sthiru/turbulence_chamber/web/1.jpg

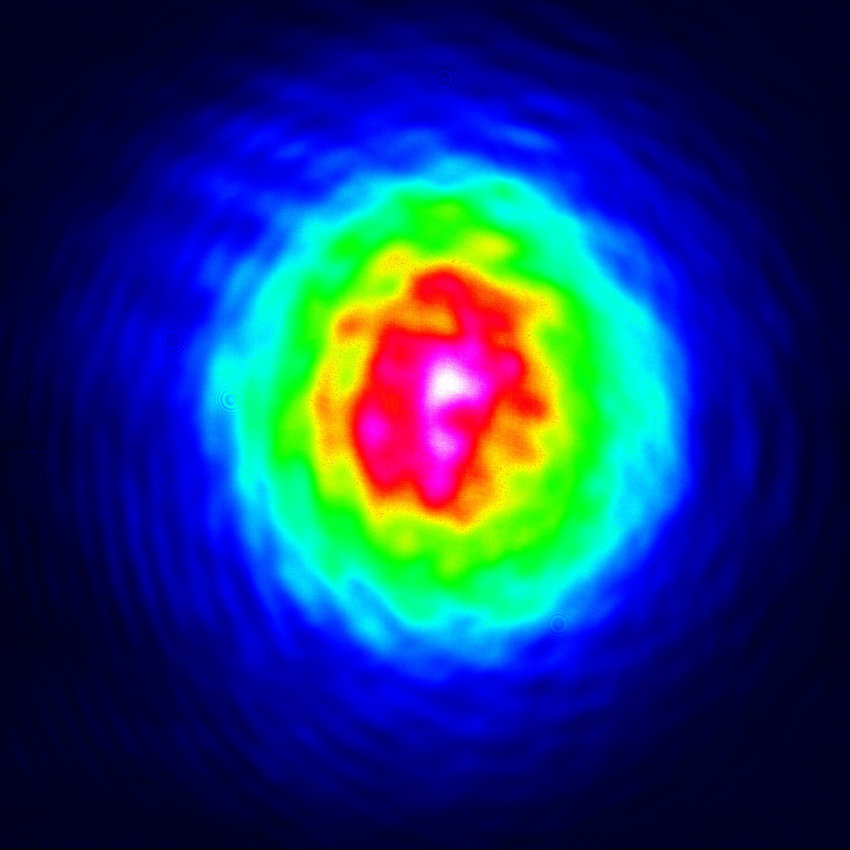
web/1.jpg
