sthiru/turbulence_chamber/calibration_data/windflow_calib_20260519_151501/calibration_data.csv

timestamp | fan_speed | sensor_0_avg | sensor_1_avg | sensor_2_avg | sensor_3_avg
2026-05-19T15:15:03.468255 | 15 | 0.117759 | -0.1286 | -0.011482 | -0.013691
2026-05-19T15:15:05.126720 | 20 | -0.05001933333333333 | -0.14201 | -0.16229866666666667 | -0.03581433333333334
2026-05-19T15:15:06.347077 | 25 | -0.108659 | -0.148715 | -0.189466 | -0.043848
2026-05-19T15:15:07.566888 | 30 | -0.08888800000000001 | -0.108659 | -0.1286 | -0.043848
2026-05-19T15:15:09.152624 | 35 | -0.11536266666666666 | -0.1286 | -0.189466 | -0.074759
2026-05-19T15:15:10.369626 | 40 | -0.108659 | -0.1286 | -0.189466 | -0.043848
2026-05-19T15:15:11.588987 | 45 | -0.069285 | -0.069285 | -0.148715 | -0.043848
2026-05-19T15:15:13.452653 | 50 | -0.10206866666666665 | -0.10882833333333332 | -0.16253033333333333 | -0.054151666666666674
2026-05-19T15:15:15.165092 | 55 | -0.037284 | -0.12195299999999999 | -0.16229866666666667 | -0.05440300000000001
2026-05-19T15:15:16.385413 | 60 | -0.069285 | -0.1286 | -0.169003 | -0.138907
2026-05-19T15:15:17.606574 | 65 | -0.011482 | -0.069285 | -0.169003 | -0.043848
2026-05-19T15:15:19.190825 | 70 | 0.0008739999999999998 | -0.049852 | -0.08240966666666666 | 0.005924333333333333
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
