sthiru/turbulence_chamber/calibration_data/windflow_calib_20260519_151501/windflow_data.csv

timestamp | step | fan_id | fan_speed | flow_rate_sensor_0 | flow_rate_sensor_1 | flow_rate_sensor_2 | flow_rate_sensor_3 | sensor_temp_0 | sensor_temp_1 | sensor_temp_2 | sensor_temp_3 | sensor_temp_4 | sensor_temp_5 | sensor_temp_6 | sensor_temp_7 | sensor_temp_8 | sensor_temp_9 | sensor_temp_10 | sensor_temp_11 | temp_hotplate1 | temp_hotplate2 | bmpTemperature_internal | bmpTemperature_external | bmpPressure_internal | bmpPressure_external | dhtTemperature_internal | dhtTemperature_external | dhtHumidity_internal | dhtHumidity_external | air_flow_0 | air_flow_1 | air_flow_2 | air_flow_3
2026-05-19T15:15:03.409338 | 1 | all | 15 | 0.117759 | -0.1286 | -0.011482 | -0.013691 | 28.0 | 25.375 | 27.1875 | 26.125 | 26.5 | 25.6875 | 24.75 | 25.75 | 25.25 | 26.0 | 25.25 | 27.25
2026-05-19T15:15:04.699962 | 2 | all | 20 | -0.05001933333333333 | -0.14201 | -0.16229866666666667 | -0.03581433333333334 | 28.0 | 25.375 | 27.1875 | 26.125 | 26.5 | 25.6875 | 24.75 | 25.75 | 25.25 | 26.0 | 25.25 | 27.25
2026-05-19T15:15:06.288640 | 3 | all | 25 | -0.108659 | -0.148715 | -0.189466 | -0.043848 | 27.9375 | 25.375 | 27.1875 | 26.125 | 26.5 | 25.6875 | 24.75 | 25.75 | 25.25 | 26.0 | 25.25 | 27.25
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
