sthiru/turbulence_chamber/calibration_data/calibration_data.csv

timestamp | fan_speed | sensor_0_avg | sensor_1_avg | sensor_2_avg | sensor_3_avg
2026-05-19T23:00:33.695771 | 15 | 0.1356 | -0.23092499999999996 | -0.011482 | -0.043848
2026-05-19T23:00:35.357202 | 20 | -0.043484999999999996 | -0.06945433333333334 | -0.09576166666666668 | 0.015012666666666669
2026-05-19T23:00:36.655126 | 25 | -0.069285 | -0.069285 | -0.148715 | 0.015732
2026-05-19T23:00:37.958576 | 30 | -0.069285 | -0.08888800000000001 | -0.169003 | 0.015732
2026-05-19T23:00:39.553179 | 35 | -0.069285 | -0.030585 | -0.148715 | -0.043848
2026-05-19T23:00:40.857397 | 40 | -0.069285 | -0.08888800000000001 | -0.148715 | -0.013691
2026-05-19T23:00:43.393942 | 45 | -0.08235366666666667 | -0.07581933333333334 | -0.122011 | -0.013691
2026-05-19T23:00:44.693126 | 50 | 0.007459 | 0.007459 | -0.1286 | -0.013691
2026-05-19T23:00:45.990155 | 55 | -0.049852 | -0.08888800000000001 | -0.108659 | 0.044443
2026-05-19T23:00:47.580486 | 60 | -0.030585 | -0.08888800000000001 | -0.069285 | -0.043848
2026-05-19T23:00:48.906778 | 65 | -0.011482 | -0.108659 | -0.049852 | 0.07246
2026-05-19T23:00:51.441155 | 70 | -0.005168333333333333 | -0.08888800000000001 | -0.09547833333333333 | -0.035025
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
