sthiru/turbulence_chamber/calibration_data/pid_data/turbulence_data_20260518_113139.csv

timestamp | session_id | temp_sensor_1 | temp_sensor_2 | temp_sensor_3 | temp_sensor_4 | temp_sensor_5 | temp_sensor_6 | temp_sensor_7 | temp_sensor_8 | temp_sensor_9 | temp_sensor_10 | temp_sensor_11 | temp_sensor_12 | temp_hotplate1 | temp_hotplate2 | bmpTemperature_internal | bmpTemperature_external | bmpPressure_internal | bmpPressure_external | dhtTemperature_internal | dhtTemperature_external | dhtHumidity_internal | dhtHumidity_external | target_temp_1 | target_temp_2 | fan_speed_1 | fan_speed_2 | fan_speed_3 | fan_speed_4 | hot_plate_1 | hot_plate_2 | flow_rate_1 | flow_rate_2 | flow_rate_3 | flow_rate_4 | cn2_row1_500 | cn2_row1_300 | cn2_row2_500 | cn2_row2_300 | cn2_optical | image_filename
2026-05-18T11:31:23.663784 | session_2026-05-18T06-01-23-053Z | 23.375 | 23.0 | 23.6875 | 23.4375 | 23.5 | 23.375 | 22.75 | 23.5 | 23.25 | 23.25 | 23.5 | 24.0 | 24.75 | 24.5 | 27.12 | 26.32 | 945.5203 | 946.0911 | -273.0 | 25.9 | 0.0 | 35.9 | 100.0 | 100.0 | 255 | 255 | 255 | 255 | True | True | 0.401474 | -0.049852 | 0.322193 | 0.044443 | 1.5485734400537575e-13 | 9.674943881185475e-14 | 4.3015928890382153e-13 | 9.674943881185475e-14 |  | camera_20260518_113123_938.png
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
