sthiru/turbulence_chamber/calibration_data/pid_data/turbulence_data_20260518_181109.csv

timestamp | session_id | temp_sensor_1 | temp_sensor_2 | temp_sensor_3 | temp_sensor_4 | temp_sensor_5 | temp_sensor_6 | temp_sensor_7 | temp_sensor_8 | temp_sensor_9 | temp_sensor_10 | temp_sensor_11 | temp_sensor_12 | temp_hotplate1 | temp_hotplate2 | bmpTemperature_internal | bmpTemperature_external | bmpPressure_internal | bmpPressure_external | dhtTemperature_internal | dhtTemperature_external | dhtHumidity_internal | dhtHumidity_external | target_temp_1 | target_temp_2 | fan_speed_1 | fan_speed_2 | fan_speed_3 | fan_speed_4 | hot_plate_1 | hot_plate_2 | flow_rate_1 | flow_rate_2 | flow_rate_3 | flow_rate_4 | cn2_row1_500 | cn2_row1_300 | cn2_row2_500 | cn2_row2_300 | cn2_optical | image_filename
2026-05-18T18:00:28.386229 | session_2026-05-18T12-30-27-949Z | 25.625 | 22.5625 | 25.0625 | 23.5625 | 24.5 | 23.3125 | 21.75 | 23.25 | 22.5 | 23.75 | 22.75 | 25.25 | 103.25 | 115.5 | 23.71 | -12.83 | 920.3487 | 942.6061 | -273.0 | -273.0 | 39.0 | 37.1 | 100.0 | 100.0 | 255 | 255 | 255 | 255 | False | False | 0.492373 | -0.011482 | 0.338316 | 0.296232 | 1.0134238366158497e-11 | 3.4175950724420715e-12 | 2.6380253972715787e-12 | 8.543987681105179e-13 |  | camera_20260518_180028_387.png
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
