sthiru/turbulence_chamber/calibration_data/pid_data/turbulence_data_20260518_223706.csv

timestamp | session_id | temp_sensor_1 | temp_sensor_2 | temp_sensor_3 | temp_sensor_4 | temp_sensor_5 | temp_sensor_6 | temp_sensor_7 | temp_sensor_8 | temp_sensor_9 | temp_sensor_10 | temp_sensor_11 | temp_sensor_12 | temp_hotplate1 | temp_hotplate2 | bmpTemperature_internal | bmpTemperature_external | bmpPressure_internal | bmpPressure_external | dhtTemperature_internal | dhtTemperature_external | dhtHumidity_internal | dhtHumidity_external | target_temp_1 | target_temp_2 | fan_speed_1 | fan_speed_2 | fan_speed_3 | fan_speed_4 | hot_plate_1 | hot_plate_2 | flow_rate_1 | flow_rate_2 | flow_rate_3 | flow_rate_4 | cn2_row1_500 | cn2_row1_300 | cn2_row2_500 | cn2_row2_300 | cn2_optical | image_filename
2026-05-18T22:14:59.239831 | session_2026-05-18T16-44-58-294Z | 24.8125 | 21.8125 | 23.8125 | 22.625 | 23.25 | 22.6875 | 21.0 | 22.25 | 21.75 | 22.75 | 22.0 | 24.0 | 122.0 | 118.0 | 24.98 | 24.81 | 945.2132 | 945.7065 | 22.9 | -273.0 | 39.0 | 0.0 | 100.0 | 100.0 | 255 | 255 | 255 | 255 | False | False | 0.536168 | -0.108659 | 0.256337 | -0.013691 | 1.0106738973377834e-11 | 2.2260501433209438e-12 | 3.19783537829533e-12 | 3.9464600878820054e-13
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
