sthiru/turbulence_chamber/calibration_data/pid_data/turbulence_data_20260518_230422.csv

timestamp | session_id | temp_sensor_1 | temp_sensor_2 | temp_sensor_3 | temp_sensor_4 | temp_sensor_5 | temp_sensor_6 | temp_sensor_7 | temp_sensor_8 | temp_sensor_9 | temp_sensor_10 | temp_sensor_11 | temp_sensor_12 | temp_hotplate1 | temp_hotplate2 | bmpTemperature_internal | bmpTemperature_external | bmpPressure_internal | bmpPressure_external | dhtTemperature_internal | dhtTemperature_external | dhtHumidity_internal | dhtHumidity_external | target_temp_1 | target_temp_2 | fan_speed_1 | fan_speed_2 | fan_speed_3 | fan_speed_4 | hot_plate_1 | hot_plate_2 | flow_rate_1 | flow_rate_2 | flow_rate_3 | flow_rate_4 | cn2_row1_500 | cn2_row1_300 | cn2_row2_500 | cn2_row2_300 | cn2_optical | image_filename
2026-05-18T22:53:31.025306 | session_2026-05-18T17-23-30-418Z | 24.6875 | 21.75 | 24.0625 | 22.75 | 23.5 | 22.75 | 0.0 | 22.75 | 22.0 | 23.0 | 22.0 | 24.5 | 100.5 | 111.0 | 25.13 | 24.82 | 945.1256 | 945.5635 | 23.1 | 23.4 | 38.7 | 36.7 | 100.0 | 100.0 | 255 | 255 | 255 | 255 | False | False | 0.354302 | -0.030585 | 0.305936 | 0.250612 | 9.686914948961821e-12 | 2.71848866593769e-12 | 5.810219479753941e-10 | 8.876697684694497e-13
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
