sthiru/turbulence_chamber/calibration_data/pid_data/turbulence_data_20260518_233700.csv

timestamp | session_id | temp_sensor_1 | temp_sensor_2 | temp_sensor_3 | temp_sensor_4 | temp_sensor_5 | temp_sensor_6 | temp_sensor_7 | temp_sensor_8 | temp_sensor_9 | temp_sensor_10 | temp_sensor_11 | temp_sensor_12 | temp_hotplate1 | temp_hotplate2 | bmpTemperature_internal | bmpTemperature_external | bmpPressure_internal | bmpPressure_external | dhtTemperature_internal | dhtTemperature_external | dhtHumidity_internal | dhtHumidity_external | target_temp_1 | target_temp_2 | fan_speed_1 | fan_speed_2 | fan_speed_3 | fan_speed_4 | hot_plate_1 | hot_plate_2 | flow_rate_1 | flow_rate_2 | flow_rate_3 | flow_rate_4 | cn2_row1_500 | cn2_row1_300 | cn2_row2_500 | cn2_row2_300 | cn2_optical | image_filename
2026-05-18T23:05:25.241983 | session_2026-05-18T17-35-24-660Z | 24.625 | 22.0 | 24.0625 | 22.875 | 23.5 | 22.375 | 21.25 | 22.5 | 22.0 | 22.75 | 22.0 | 24.5 | 101.25 | 89.75 | 24.99 | 24.75 | 944.785 | 945.3376 | -273.0 | -273.0 | 38.6 | 0.0 | 100.0 | 100.0 | 255 | 255 | 255 | 255 | False | True | 0.578911 | -0.273107 | 0.239522 | 0.494911 | 7.737192960962481e-12 | 2.2258260227207912e-12 | 1.4211170744624964e-12 | 3.9460627549620673e-13
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
