sthiru/turbulence_chamber/server/camera_acquisition.py

# -*- coding: utf-8 -*-
"""
Camera acquisition module for GigE Basler camera using Pylon SDK
Created for turbulence controller system
"""

import os
import time
import logging
import re
from datetime import datetime
from typing import Optional, Tuple, Dict, Any, Iterator, Generator
import cv2
import numpy as np
import threading
import queue
import base64
from io import BytesIO
from PIL import Image
from constants import (
    CAMERA_IMAGES_FOLDER,
    CAMERA_FRAME_QUEUE_SIZE,
    CAMERA_RETRIEVE_TIMEOUT,
    CAMERA_FILENAME_FORMAT,
    CAMERA_VIDEO_FRAME_DELAY,
    CAMERA_JPEG_QUALITY,
    CAMERA_IMAGE_EXTENSION
)

# Try to import pylon, provide fallback if not available
try:
    from pypylon import pylon
    PYLON_AVAILABLE = True
    # Debug: Print Pylon version info
    try:
        print(f"Pylon version: {pylon.PYLON_VERSIONSTRING_BUILD}")
        print(f"Pylon git sha: {pylon.PYLON_VERSIONSTRING_GITHASH}")
    except:
        print("Could not get Pylon version info")
except ImportError:
    PYLON_AVAILABLE = False

logger = logging.getLogger(__name__)

class BaslerCamera:
    """GigE Basler camera acquisition using Pylon SDK (Singleton)"""
    
    _instance = None
    _lock = threading.Lock()
    
    def __new__(cls, camera_images_folder: str = CAMERA_IMAGES_FOLDER):
        if cls._instance is None:
            with cls._lock:
                if cls._instance is None:
                    cls._instance = super().__new__(cls)
                    cls._instance._initialized = False
        return cls._instance
    
    def __init__(self, camera_images_folder: str = CAMERA_IMAGES_FOLDER):
        """
        Initialize camera acquisition (singleton)
        
        Args:
            camera_images_folder: Directory to save captured images
        """
        # Only initialize once
        if self._initialized:
            return
            
        self.camera_images_folder = camera_images_folder
        self.camera = None
        self.is_initialized = False
        self.is_connected = False
        
        # Camera settings
        self.camera_settings = {}  # Store loaded pfs settings
        
        # Video streaming variables
        self.is_streaming = False
        self.streaming_thread = None
        self.frame_queue = queue.Queue(maxsize=CAMERA_FRAME_QUEUE_SIZE)  # Buffer for video frames
        self.streaming_clients = []  # List of connected streaming clients
        
        # Ensure camera images folder exists
        os.makedirs(self.camera_images_folder, exist_ok=True)
        
        # Camera info
        self.camera_info = {}
        
        self._initialized = True
    
    @classmethod
    def get_instance(cls, camera_images_folder: str = CAMERA_IMAGES_FOLDER) -> 'BaslerCamera':
        """Get or create the singleton camera instance"""
        return cls(camera_images_folder)
    
    @classmethod
    def reset_instance(cls):
        """Reset the singleton instance (for testing)"""
        with cls._lock:
            if cls._instance:
                cls._instance.cleanup()
            cls._instance = None
        
    def load_pfs_settings(self, pfs_file_path: str) -> bool:
        """
        Load camera settings from a PFS (Pylon Feature Set) file
        
        Args:
            pfs_file_path: Path to the .pfs file
            
        Returns:
            bool: True if settings loaded successfully, False otherwise
        """
        try:
            if not os.path.exists(pfs_file_path):
                logger.error(f"PFS file not found: {pfs_file_path}")
                return False
                
            if not PYLON_AVAILABLE:
                logger.warning("Pylon SDK not available - cannot load PFS file")
                return False
                
            logger.info(f"Loading camera settings from PFS file: {pfs_file_path}")
            
            # Load and parse PFS file
            self.camera_settings = self._parse_pfs_file(pfs_file_path)
            
            # Log all loaded settings
            logger.info(f"Successfully loaded {len(self.camera_settings)} camera settings from PFS file")
                
            return True
            
        except Exception as e:
            logger.error(f"Failed to load PFS file {pfs_file_path}: {e}")
            return False
    
    def _parse_pfs_file(self, pfs_file_path: str) -> Dict[str, Any]:
        """
        Parse PFS file and extract camera settings
        
        Args:
            pfs_file_path: Path to the PFS file
            
        Returns:
            Dict containing camera parameter names and values
        """
        settings = {}
        
        try:
            with open(pfs_file_path, 'r') as f:
                lines = f.readlines()
                
            # Parse each line for parameter=value pairs
            for line in lines:
                line = line.strip()
                
                # Skip comments and empty lines
                if line.startswith('#') or not line or '\t' not in line:
                    continue
                    
                # Split parameter and value
                parts = line.split('\t')
                if len(parts) >= 2:
                    param_name = parts[0].strip()
                    param_value = parts[1].strip()
                    
                    # Convert value to appropriate type
                    if param_value.replace('.', '').isdigit():
                        # Numeric value
                        if '.' in param_value:
                            settings[param_name] = float(param_value)
                        else:
                            settings[param_name] = int(param_value)
                    else:
                        # String value
                        settings[param_name] = param_value
                        
        except Exception as e:
            logger.warning(f"Error parsing PFS file: {e}")
            
        return settings
    
    def apply_pfs_settings_to_camera(self) -> bool:
        """
        Apply loaded PFS settings to the camera
        
        Returns:
            bool: True if settings applied successfully, False otherwise
        """
        try:
            if not self.camera or not self.camera.IsOpen():
                logger.error("Camera not available for applying settings")
                return False
                
            if not self.camera_settings:
                logger.warning("No PFS settings loaded to apply")
                return False
                
            logger.info("Applying PFS settings to camera...")
            
            # Apply all settings from PFS file
            for camera_param, value in self.camera_settings.items():
                try:
                    if hasattr(self.camera, camera_param):
                        param = getattr(self.camera, camera_param)
                        if hasattr(param, 'SetValue'):
                            param.SetValue(value)
                            logger.info(f"Applied {camera_param}: {value}")
                        elif hasattr(param, 'FromString'):
                            param.FromString(value)
                            logger.info(f"Applied {camera_param}: {value}")
                except Exception as e:
                    logger.warning(f"Could not set {camera_param} to {value}: {e}")
            
            logger.info("PFS settings applied successfully")
            return True
            
        except Exception as e:
            logger.error(f"Failed to apply PFS settings: {e}")
            return False
    
    def initialize_camera(self, pfs_file_path: str = None) -> bool:
        """Initialize the camera"""
        try:
            if not PYLON_AVAILABLE:
                logger.error("Pylon SDK not available - cannot initialize camera")
                return False
                    
            # Create an instant camera object
            tlFactory = pylon.TlFactory.GetInstance()

            # Enumerate all devices with detailed info
            devices = tlFactory.EnumerateDevices()
            logger.info(f"Found {len(devices)} Basler devices")
            # Try to force GigE transport layer

            if len(devices) == 0:
                # Disable camera stream
                logger.error("No Basler cameras found")
                return False
                
            # Create camera object
            self.camera = pylon.InstantCamera(tlFactory.CreateFirstDevice())
            
            # Open camera
            self.camera.Open()

            if pfs_file_path and os.path.exists(pfs_file_path):
                if self.load_pfs_settings(pfs_file_path):
                    if not self.apply_pfs_settings_to_camera(): # Apply PFS settings if loaded
                        logger.error("Failed to apply PFS settings")
                        
            # Get camera info with compatibility handling
            device_info = self.camera.GetDeviceInfo()
            self.camera_info = {
                "model": device_info.GetModelName(),
                "serial": device_info.GetSerialNumber(),
                "vendor": device_info.GetVendorName(),
                "firmware": getattr(device_info, 'GetFirmwareVersion', lambda: 'Unknown')()
            }
            
            self.is_initialized = True
            logger.info(f"Camera initialized: {self.camera_info['model']} (S/N: {self.camera_info['serial']})")
            return True
            
        except Exception as e:
            logger.error(f"Failed to initialize camera: {e}")
            return False
    
    def connect_camera(self) -> bool:
        """Connect to the camera"""
        try:
            logger.info(f"Attempting to connect camera - Initialized: {self.is_initialized}")
            
            if not self.is_initialized:
                logger.info("Camera not initialized, attempting initialization...")
                if not self.initialize_camera():
                    logger.error("Failed to initialize camera during connection attempt")
                    return False
                    
            if not PYLON_AVAILABLE:
                logger.error("Pylon SDK not available - cannot connect camera")
                return False
            
            if self.camera and not self.camera.IsOpen():
                logger.info("Opening camera...")
                self.camera.Open()
                logger.info("Camera opened successfully")
                
            # Start grabbing
            logger.info("Starting image grabbing...")
            self.camera.StartGrabbing(pylon.GrabStrategy_LatestImageOnly)
            logger.info("Image grabbing started successfully")
            
            self.is_connected = True
            logger.info("Camera connected and ready for acquisition")
            return True
            
        except Exception as e:
            logger.error(f"Failed to connect camera: {e}")
            import traceback
            traceback.print_exc()
            return False
    
    def disconnect_camera(self):
        """Disconnect from the camera"""
        try:
            if self.camera and self.camera.IsOpen():
                if self.camera.IsGrabbing():
                    self.camera.StopGrabbing()
                self.camera.Close()
                
            self.is_connected = False
            logger.info("Camera disconnected")
            
        except Exception as e:
            logger.error(f"Error disconnecting camera: {e}")
    
    def capture_image(self) -> Optional[np.ndarray]:
        """
        Capture a single image from the camera
        
        Returns:
            numpy.ndarray: Captured image in OpenCV format, or None if failed
        """
        try:
            if not self.is_connected:
                if not self.connect_camera():
                    return None
                
            # Check if camera object is valid
            if not self.camera or not hasattr(self.camera, 'RetrieveResult'):
                logger.error("Camera object is not valid for image capture")
                return None
                
            # Grab image
            try:
                grabResult = self.camera.RetrieveResult(CAMERA_RETRIEVE_TIMEOUT, pylon.TimeoutHandling_ThrowException)
            except Exception as e:
                logger.error(f"Error calling RetrieveResult: {e}")
                return None
            
            if grabResult.GrabSucceeded():
                # Convert to OpenCV format
                image = grabResult.GetArray()
                
                # Convert to uint8 if needed
                if image.dtype != np.uint8:
                    image = image.astype(np.uint8)
                
                # Ensure image is 2D (grayscale)
                if len(image.shape) == 3:
                    image = cv2.cvtColor(image, cv2.COLOR_BGR2GRAY)
                    
                grabResult.Release()
                return image
            else:
                logger.error(f"Failed to grab image: {grabResult.ErrorCode} {grabResult.ErrorDescription}")
                grabResult.Release()
                return None
                
        except Exception as e:
            logger.error(f"Error capturing image: {e}")
            import traceback
            traceback.print_exc()
            return None
    
    def save_image(self, image: np.ndarray, timestamp: Optional[datetime] = None, folder: Optional[str] = None) -> Optional[str]:
        """
        Save captured image to file
        
        Args:
            image: Image to save (numpy array)
            timestamp: Timestamp for filename (defaults to current time)
            folder: Optional folder to save to (defaults to self.camera_images_folder)
            
        Returns:
            str: Filename of saved image, or None if failed
        """
        try:
            if timestamp is None:
                timestamp = datetime.now()
                
            # Generate filename with timestamp
            filename = f"camera_{timestamp.strftime(CAMERA_FILENAME_FORMAT)}{CAMERA_IMAGE_EXTENSION}"
            save_folder = folder or self.camera_images_folder
            filepath = os.path.join(save_folder, filename)
            
            # Save image
            success = cv2.imwrite(filepath, image)
            
            if success:
                logger.info(f"Image saved: {filepath}")
                return filepath
            else:
                logger.error(f"Failed to save image: {filepath}")
                return None
                
        except Exception as e:
            logger.error(f"Error saving image: {e}")
            return None
    
    def capture_and_save(self, folder: Optional[str] = None) -> Optional[str]:
        """
        Capture and save an image in one operation
        
        Args:
            folder: Optional folder to save to (defaults to self.camera_images_folder)
        
        Returns:
            str: Filename of saved image, or None if failed
        """
        try:
            timestamp = datetime.now()
            image = self.capture_image()
            
            if image is not None:
                filename = self.save_image(image, timestamp, folder)
                return filename
            else:
                logger.warning("Failed to capture image - capture_image returned None")
                return None
                
        except Exception as e:
            logger.error(f"Error in capture_and_save: {e}")
            import traceback
            traceback.print_exc()
            return None
    
    def start_video_stream(self) -> bool:
        """
        Start video streaming from the camera
        
        Returns:
            bool: True if streaming started successfully, False otherwise
        """
        try:
            if self.is_streaming:
                logger.warning("Video streaming is already active")
                return True
                
            if not self.is_connected:
                if not self.connect_camera():
                    logger.error("Failed to connect camera for video streaming")
                    return False
            
            self.is_streaming = True
            self.streaming_thread = threading.Thread(target=self._video_stream_worker, daemon=True)
            self.streaming_thread.start()
            
            logger.info("Video streaming started successfully")
            return True
            
        except Exception as e:
            logger.error(f"Failed to start video streaming: {e}")
            self.is_streaming = False
            return False
    
    def stop_video_stream(self):
        """Stop video streaming"""
        try:
            self.is_streaming = False
            
            if self.streaming_thread and self.streaming_thread.is_alive():
                self.streaming_thread.join(timeout=CAMERA_VIDEO_FRAME_DELAY * 10)
            
            # Clear frame queue
            while not self.frame_queue.empty():
                try:
                    self.frame_queue.get_nowait()
                except queue.Empty:
                    break
            
            logger.info("Video streaming stopped")
            
        except Exception as e:
            logger.error(f"Error stopping video streaming: {e}")
    
    def _video_stream_worker(self):
        """Worker thread for continuous video capture"""
        logger.info("Video streaming worker started")
        
        while self.is_streaming:
            try:
                # Capture frame
                image = self.capture_image()
                
                if image is not None:
                    # Convert frame to JPEG for streaming
                    frame_data = self._encode_frame_for_streaming(image)
                    
                    if frame_data:
                        # Add frame to queue (non-blocking, drop if full)
                        try:
                            self.frame_queue.put_nowait(frame_data)
                        except queue.Full:
                            # Drop oldest frame and add new one
                            try:
                                self.frame_queue.get_nowait()
                                self.frame_queue.put_nowait(frame_data)
                            except queue.Empty:
                                pass
                    else:
                        logger.warning("Failed to encode frame for streaming")
                else:
                    logger.warning("Failed to capture image for streaming")
                
                # Small delay to control frame rate
                time.sleep(CAMERA_VIDEO_FRAME_DELAY)
                
            except Exception as e:
                logger.error(f"Error in video streaming worker: {e}")
                time.sleep(0.1)  # Brief delay on error
        
        logger.info("Video streaming worker stopped")
    
    def _encode_frame_for_streaming(self, image: np.ndarray) -> Optional[str]:
        """
        Encode frame for streaming as base64 JPEG
        
        Args:
            image: numpy array image
            
        Returns:
            str: Base64 encoded JPEG image, or None if failed
        """
        try:
            # Convert grayscale to RGB for better JPEG compression
            if len(image.shape) == 2:
                image_rgb = cv2.cvtColor(image, cv2.COLOR_GRAY2RGB)
            else:
                image_rgb = image
            
            # Encode to JPEG
            _, buffer = cv2.imencode('.jpg', image_rgb, [cv2.IMWRITE_JPEG_QUALITY, CAMERA_JPEG_QUALITY])
            
            # Convert to base64
            frame_b64 = base64.b64encode(buffer).decode('utf-8')
            
            return frame_b64
            
        except Exception as e:
            logger.error(f"Error encoding frame for streaming: {e}")
            return None
    
    def get_latest_frame(self) -> Optional[str]:
        """
        Get the latest frame from the video stream
        
        Returns:
            str: Base64 encoded JPEG image, or None if no frame available
        """
        try:
            return self.frame_queue.get_nowait()
        except queue.Empty:
            return None
    
    def add_streaming_client(self, client_id: str):
        """Add a client to the streaming clients list"""
        if client_id not in self.streaming_clients:
            self.streaming_clients.append(client_id)
            logger.info(f"Added streaming client: {client_id}")
    
    def remove_streaming_client(self, client_id: str):
        """Remove a client from the streaming clients list"""
        if client_id in self.streaming_clients:
            self.streaming_clients.remove(client_id)
            logger.info(f"Removed streaming client: {client_id}")
    
    def get_streaming_status(self) -> dict:
        """Get current streaming status"""
        return {
            "is_streaming": self.is_streaming,
            "connected_clients": len(self.streaming_clients),
            "frame_queue_size": self.frame_queue.qsize(),
            "camera_connected": self.is_connected
        }
    
    def get_camera_status(self) -> dict:
        """Get current camera status"""
        status = {
            "initialized": self.is_initialized,
            "connected": self.is_connected,
            "is_streaming": self.is_streaming,
            "available": PYLON_AVAILABLE,
            "camera_info": self.camera_info,
            "image_folder": self.camera_images_folder
        }
        
        # Add camera-specific status if connected
        if self.is_connected and self.camera and PYLON_AVAILABLE:
            try:
                status.update({
                    "exposure_time": self.camera.ExposureTime.GetValue(),
                    "gain": self.camera.Gain.GetValue(),
                    "temperature": self.camera.DeviceTemperature.GetValue() if hasattr(self.camera, 'DeviceTemperature') else None
                })
            except Exception as e:
                logger.warning(f"Could not read camera parameters: {e}")
                
        return status
    
    def cleanup(self):
        """Cleanup camera resources"""
        try:
            # Stop video streaming first
            self.stop_video_stream()
            
            self.disconnect_camera()
            if self.camera:
                self.camera.Close()
                self.camera = None
            self.is_initialized = False
            logger.info("Camera cleanup completed")
            
        except Exception as e:
            logger.error(f"Error during camera cleanup: {e}")
