sthiru/turbulence_chamber/server/ws_connection_manager.py

"""
WebSocket connection manager for real-time status updates
"""
import logging
from typing import List
from fastapi import WebSocket

logger = logging.getLogger(__name__)


class ConnectionManager:
    """Manages WebSocket connections for broadcasting status updates"""
    
    def __init__(self):
        self.active_connections: List[WebSocket] = []

    async def connect(self, websocket: WebSocket):
        """Accept and store new WebSocket connection"""
        await websocket.accept()
        self.active_connections.append(websocket)
        logger.info(f"WebSocket client connected. Total connections: {len(self.active_connections)}")

    def disconnect(self, websocket: WebSocket):
        """Remove WebSocket connection"""
        if websocket in self.active_connections:
            self.active_connections.remove(websocket)
            logger.info(f"WebSocket client disconnected. Total connections: {len(self.active_connections)}")

    async def send_personal_message(self, message: str, websocket: WebSocket):
        """Send message to specific WebSocket client"""
        await websocket.send_text(message)

    async def broadcast(self, message: str):
        """Broadcast message to all connected WebSocket clients"""
        for connection in self.active_connections:
            try:
                await connection.send_text(message)
            except:
                # Connection closed, remove it
                logger.warning("Failed to send to WebSocket client, removing connection")
                self.active_connections.remove(connection)
