sthiru/turbulence_chamber/server/ws_calibration_manager.py

from typing import List
from fastapi import WebSocket
import json 

# Configure logging
import logging
logging.basicConfig(level=logging.INFO)
logger = logging.getLogger(__name__)

# Calibration WebSocket connection manager
class CalibrationConnectionManager:
    def __init__(self):
        self.active_connections: List[WebSocket] = []
    
    async def connect(self, websocket: WebSocket):
        await websocket.accept()
        self.active_connections.append(websocket)
        logger.info(f"Calibration WebSocket client connected. Total: {len(self.active_connections)}")
    
    def disconnect(self, websocket: WebSocket):
        if websocket in self.active_connections:
            self.active_connections.remove(websocket)
            logger.info(f"Calibration WebSocket client disconnected. Total: {len(self.active_connections)}")
    
    async def broadcast(self, message: dict):
        """Broadcast calibration status to all connected clients"""
        for connection in self.active_connections:
            try:
                await connection.send_text(json.dumps(message))
            except Exception as e:
                logger.error(f"Error sending calibration status to client: {e}")
                self.disconnect(connection)
