sthiru/turbulence_chamber/(commit log)

2026-02-27 Initial commit: Temperature Control System with Arduino, FastAPI, and Web Interface
2026-03-06 updated arduino_comm
2026-03-18 updated arduino code and scripts
2026-03-23 added cn2 measure using camera image
2026-03-23 Add README for camera images directory
2026-03-26 camera settings file
2026-03-26 load camera settings from file
2026-03-26 fixed the fan animation
2026-03-26 fixed camera setting loading
    [camera_acquisition.py]
2026-04-01 added camera live feed
2026-04-06 updated logs for the arduino comm
2026-05-03 working code with 12 temp and 4 air flow sensors
2026-05-04 fixed multi spi connection and refactored web
    [temperature_control.ino]
2026-05-04 fixed arduino model error.
    [models.py]
2026-05-04 added ambient sensor data
2026-05-06 added documents and calibration design.
2026-05-07 added calibration of windflow sensor and fan
2026-05-08 improved arduino comm
2026-05-08 updated the fan control in svg
    [calibration_data.csv]
2026-05-08 added setWaitForConversion to temp sensor
    [calibration_data.csv]
2026-05-09 updated calibration
    [calibration_data.csv]
2026-05-10 adjusted chamber and component positions, reduced polling interval to 1s
2026-05-11 converted arduino serial output to JSON format for structured logging and improved error handling in python server
    [calibration_data.csv, hotplate_data.csv]
2026-05-13 fixed the temp sensor mapping in ux
    [temperature_control.ino]
2026-05-13 updated the internal external sensor models
2026-05-14 updated sensor data model to use descriptive names for BMP, DHT, and hotplate sensors, refactored CSV headers and data mapping across calibration and main modules, added camera_images to gitignore, f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
    [main.py, models.py]
2026-05-16 updated README with expanded system specifications, added Arduino settings sync via apply_settings command, created configuration page, removed control-panel.html, updated navigation links across web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
2026-05-17 updated PID controller to support independent tuning per hotplate, changed default target temperature to 100°C, moved settings.json to arduino folder, refactored file path handling to use workspace r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
    [arduino_comm.py, main.py, temperature_control.ino]
2026-05-18 added debug_enabled setting to control Arduino verbose logging, updated sensor 13 address to 2866dd4800000021, wrapped error messages in debug mode checks
    [main.py, temperature_control.ino]
2026-05-18 updated calibration agent to map individual internal/external BMP and DHT sensor readings, added session config persistence, increased status callback frequency during calibration steps, fixed calibr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
    [calibration_data.csv, windflow_data.csv]
2026-05-18 changed PID control from binary on/off to time-proportional window-based control with 3-second windows, updated default PID parameters to kp=5.0/ki=0.1/kd=60.0, fixed settings file path resolution in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
    [main.py, temperature_control.ino]
2026-05-18 fixed syntax errors in PID variable declarations and replaced hardcoded Setpoint references with targetTemperatures array for independent hotplate control
    [temperature_control.ino]
2026-05-18 added pid calibration data
    [turbulence_data_20260518_113139.csv, turbulence_data_20260518_181109.csv, turbulence_data_20260518_223706.csv, turbulence_data_20260518_230422.csv, turbulence_data_20260518_233700.csv, turbulence_data_20260518_234232.csv, turbulence_data_20260518_235903.csv]
2026-05-19 initialized windowStartTime to millis(), updated PID parameters to kp=8.0/ki=0.08/kd=80.0, added full-power heating when temperature is 15°C below target, added integral windup prevention by zeroing 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
    [calibration_data.csv]
2026-05-19 added calibration data files
    [calibration_data.csv, turbulence_data_20260519_160150.csv, turbulence_data_20260519_190053.csv, windflow_data.csv]
2026-05-19 added 105 calibration data
    [turbulence_data_20260519_193522.csv]
2026-05-19 deleted camera_images folder, added calibration data save/download API endpoints with metadata support, updated calibration.js to load data from fan_data.csv instead of latest-data endpoint, added au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
2026-05-19 added temperature rate-of-change braking to prevent overshoot, initialized last_hotplate1Temp and last_hotplate2Temp tracking variables, applied 75% power reduction when temperature rises faster than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
    [temperature_control.ino]
2026-05-20 added calibration data from my laptop
    [calibration_data.csv, session_2026-05-19T18-02-19-360Z.csv, session_2026-05-19T18-26-11-114Z.csv, session_2026-05-19T18-28-11-827Z.csv, session_2026-05-19T18-33-48-925Z.csv, session_2026-05-19T18-34-05-858Z.csv, session_2026-05-19T18-39-56-152Z.csv]
2026-05-21 updated camera acq
2026-05-21 removed unused code including combined calibration methods, CSV utility imports, sensor data capture function, windflow/hotplate/combined calibration save methods, incremental data saving functions, 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
2026-05-21 fixed data acq and camera settings
    [main.py]
2026-05-22 removed current_session.json file, fixed Pylon version info access, disabled camera simulation fallback, reduced camera logging verbosity, reorganized main.py initialization order and global variable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
    [camera_acquisition.py, main.py]
2026-05-22 renamed WebSocket manager files from websocket_manager.py to ws_connection_manager.py, video_stream_manager.py to ws_video_stream_manager.py, and calibration_websocket_manager.py to ws_calibration_ma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
2026-05-22 refactor camera acquisition and main modules for improved initialization and functionality; remove unused bottom bar component
2026-05-22 converted BaslerCamera to singleton pattern with thread-safe instance management, removed global camera_instance and helper functions from camera_acquisition.py, updated main.py to use BaslerCamera.g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
2026-05-22 added optional folder parameter to save_image and capture_and_save methods in BaslerCamera, removed capture_and_save_image helper function from main.py, updated background_status_polling to use camer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
2026-05-22 refactor BaslerCamera initialization to accept optional PFS file path, update main.py to reflect changes, and improve video frame handling in camera.js and index.html
2026-05-22 removed unused camera video stream API endpoints and refactored video_streaming_worker to automatically manage camera streaming based on active WebSocket clients, stop video streaming when no clients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
2026-05-22 changed BaslerCamera.save_image to return full filepath instead of filename, updated CN2OpticalCalculator.calculate_beam_centroid to return (0,0) tuple instead of None on errors, modified cn2_thermal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
    [camera_acquisition.py, csv_utils.py, main.py, utils.py]
2026-05-24 added acquisition_type parameter to data capture API for organizing captures into type-specific subfolders, updated optical CN² calculation to require minimum 30 centroid data points before computing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
2026-05-24 moved calibration page styles from inline to style.css, renamed calibration button IDs for clarity (startCalibration to startWindflowCalibration, startHotplateCalibration to start4DCalibration), cons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
2026-05-24 added gausion fit cn2 sample program
2026-05-24 add calibration data
    [turbulance_data20260522_215038_data.csv, turbulance_data20260522_215427_data.csv, turbulance_data20260522_221600_data.csv, turbulance_data20260522_221622_data.csv, turbulance_data20260522_222338_data.csv, turbulance_data20260523_214337_data.csv, turbulance_data20260523_214401_data.csv, turbulance_data20260523_214412_data.csv]
2026-05-24 fix import issue on utils
    [utils.py]
2026-05-24 fixed fan controls
2026-05-26 added type hints for calibration results, added _capture_sensor_data and _save_combined_calibration helper methods, updated session type detection to include 'pid' and 'turbulence' types, removed unn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
2026-07-18 use PT100 for hot plate temp
2026-07-20 added SCPI protocol support to Arduino controller
2026-07-20 refactor temperature control logic to simplify hotplate temperature handling and add validation for temperature range
2026-07-22 added Cn2 target control with lookup-table based actuator setpoints, integrated target application into data capture workflow, added temperature trend chart group filtering, and updated configuration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
2026-07-24 set default values if dht11 and bmp280 is not working
    [temperature_control.ino]
2026-07-24 refactored image capture to independent high-speed worker task, decoupled from status polling loop, and updated temperature validation to use safetyTemperature instead of MAX_TEMP constant
